saadr95/AquaControl/3d/v1.0/AquaControl_Divider.stl

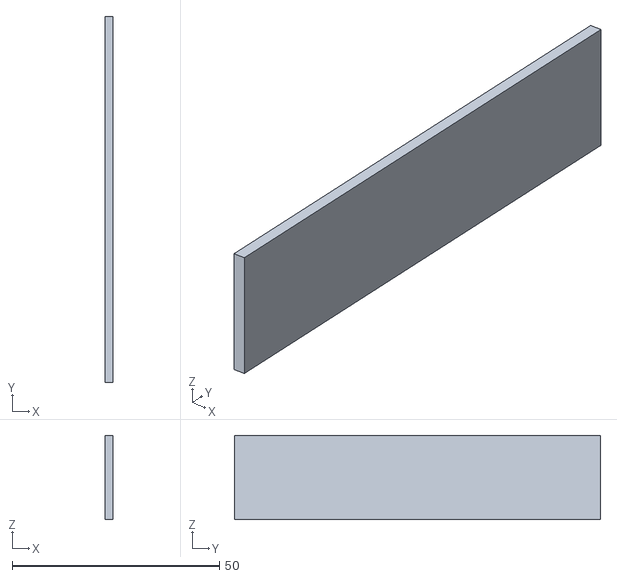
[picture p1: CAD file, 2026-08-20]
3d/v1.0/AquaControl_Divider.stl
2.00 x 88.4 x 20.4
