saadr95/AquaControl/3d/v1.0/AquaControl_Base.stl

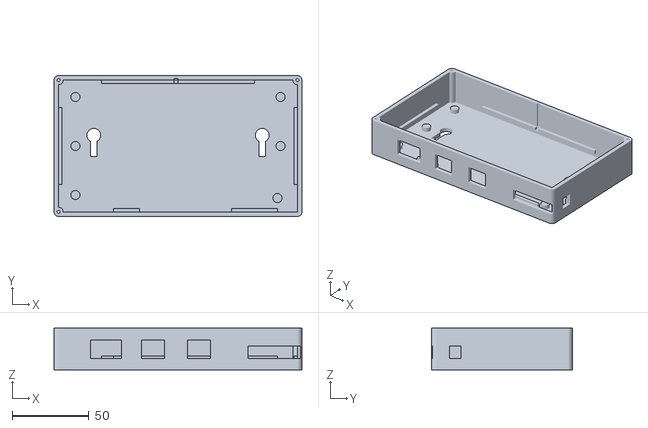
[picture p2: CAD file, 2026-08-20]
3d/v1.0/AquaControl_Base.stl
162.0 x 92.0 x 27.4
