saadr95/AquaControl/3d/v1.0/AquaControl_Enclosure.stl

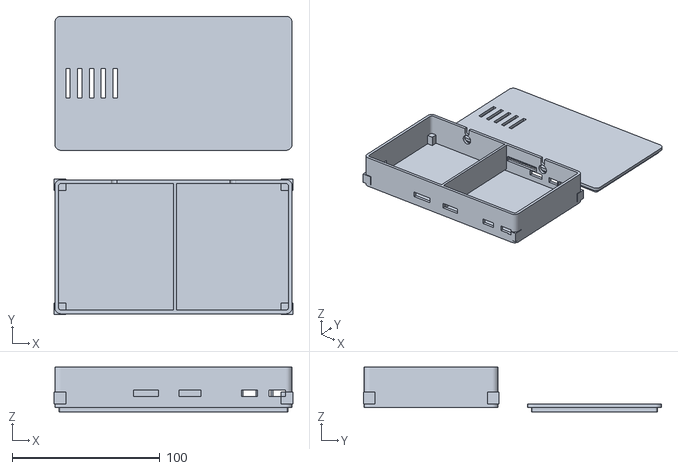
[picture p3: CAD file, 2026-08-20]
3d/v1.0/AquaControl_Enclosure.stl
162.0 x 202.2 x 30.4
