saadr95/AquaControl/3d/v1.0/AquaControl_Lid.stl

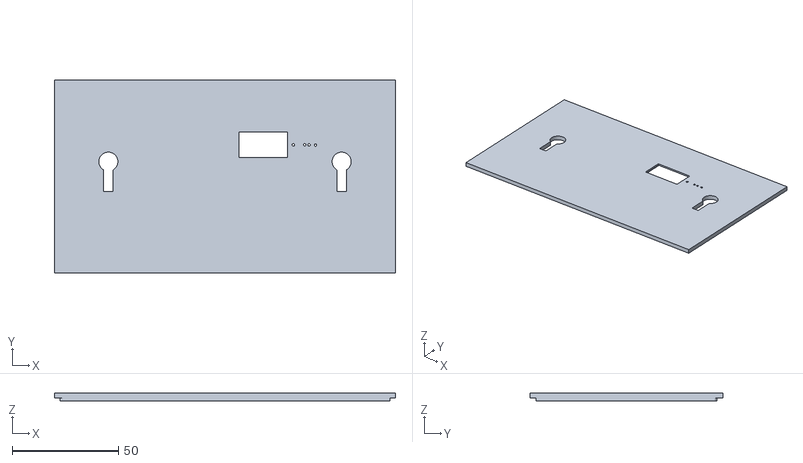
[picture p4: CAD file, 2026-08-20]
3d/v1.0/AquaControl_Lid.stl
160.8 x 90.8 x 3.90
