saadr95/AquaControl/kicad/v1.0/Esp32-01.pdf

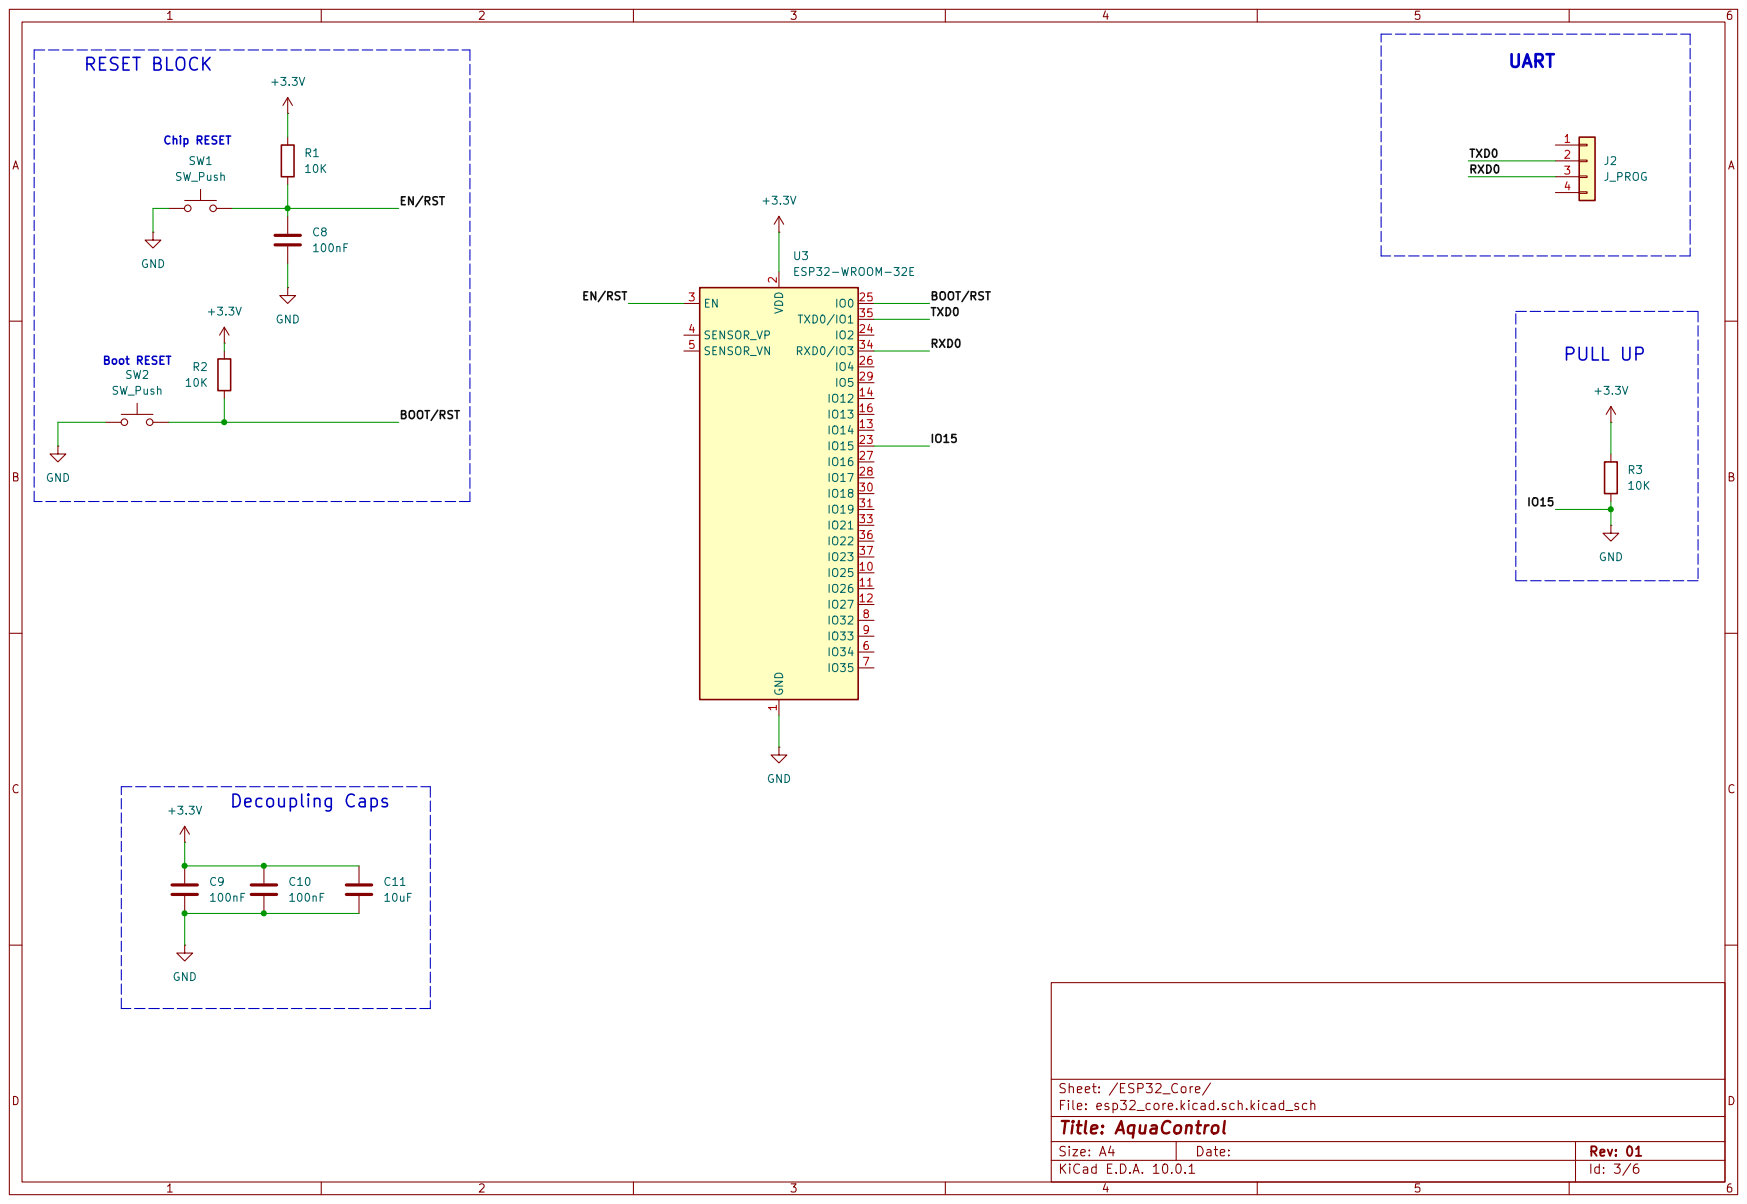
[picture p5: page 1]
