saadr95/AquaControl/(list of files, drawings)

Other design files:
kicad/v1.1/freerouting.dsn
kicad/v1.1/temp-freerouting.dsn
