saadr95/AquaControl/kicad/v1.1/AquaControl.kicad_pcb

## KiCad design kicad/v1.1/AquaControl.kicad_pcb (2026-08-20)

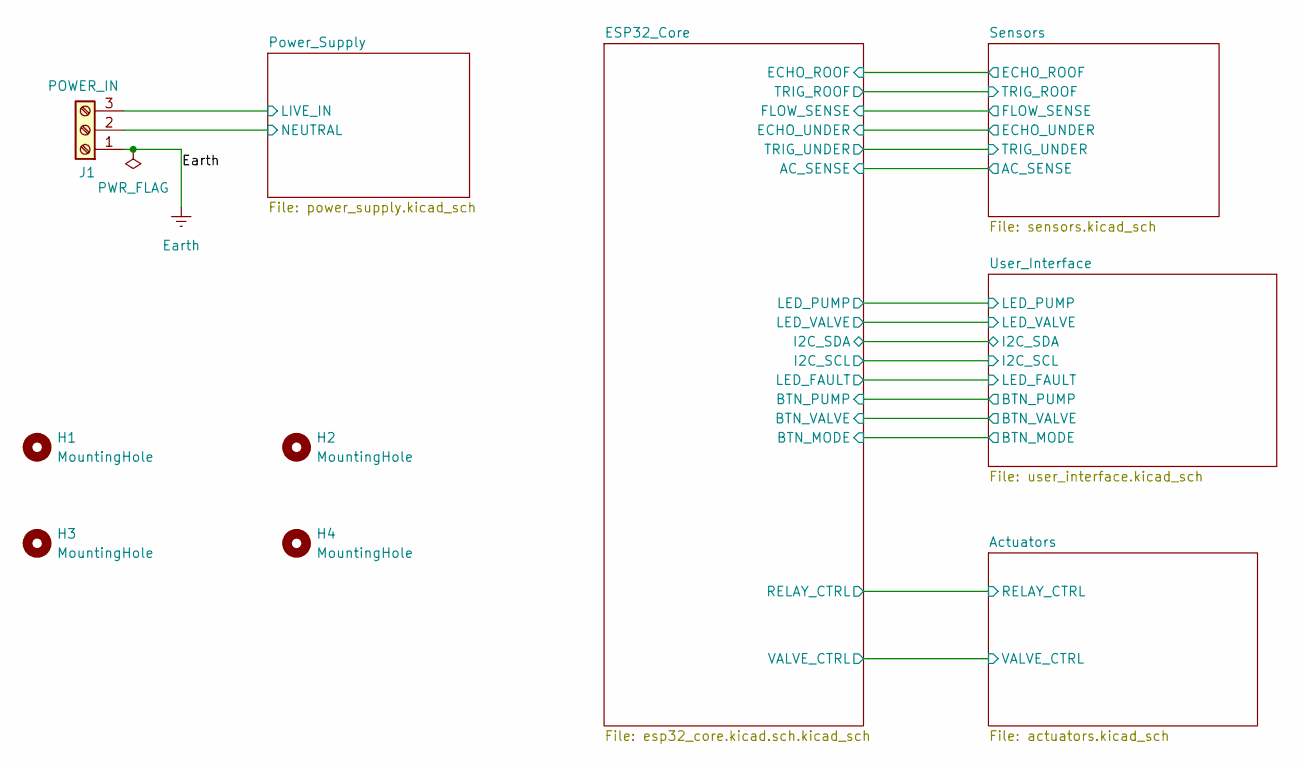
[picture p6: schematic AquaControl.kicad_sch]

Parts:
H1, H2, H3, H4: MountingHole; MountingHole_3.2mm_M3
J1: POWER_IN; TerminalBlock_Phoenix_MKDS-1,5-3_1x03_P5.00mm_Horizontal; LCSC C8427

Connections:
/Power_Supply/LIVE_IN: J1.3; also elsewhere on the board
/Power_Supply/NEUTRAL: J1.2; also elsewhere on the board
Earth: J1.1

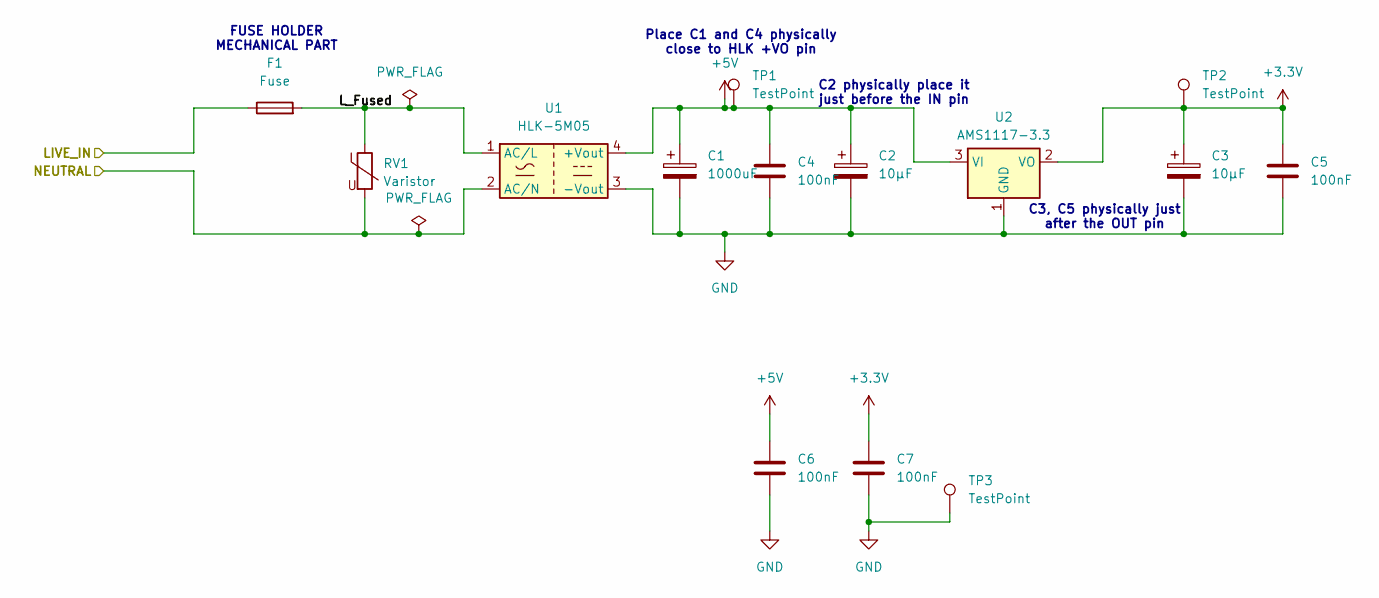
[picture p7: schematic power_supply.kicad_sch, AquaControl]

Parts:
C1: 1000uF; CP_Radial_D10.0mm_P5.00mm; LCSC C503217
C2, C3: 10µF; CP_Radial_D5.0mm_P2.50mm; LCSC C19712075
C4, C5, C6, C7: 100nF; C_0603_1608Metric; LCSC C14663
F1: Fuse; Fuseholder_Cylinder-5x20mm_Bulgin_FX0456_Vertical_Closed
RV1: Varistor; RV_Disc_D9mm_W3.3mm_P5mm; LCSC C125492
TP1, TP2, TP3: TestPoint; TestPoint_Pad_D1.0mm
U1: HLK-5M05; Converter_ACDC_Hi-Link_HLK-5Mxx; LCSC C48935095
U2: AMS1117-3.3; SOT-223-3_TabPin2; LCSC C6186

Connections:
+3.3V: C3.1, C5.1, C7.1, TP2.1 (1_1), U2.2 (VO); also elsewhere on the board
+5V: C1.1, C2.1, C4.1, C6.1, TP1.1 (1_1), U1.4 (+Vout), U2.3 (VI); also elsewhere on the board
/Power_Supply/LIVE_IN: F1.1; also elsewhere on the board
/Power_Supply/L_Fused: F1.2, RV1.1, U1.1 (AC/L)
/Power_Supply/NEUTRAL: RV1.2, U1.2 (AC/N); also elsewhere on the board
GND: C1.2, C2.2, C3.2, C4.2, C5.2, C6.2, C7.2, TP3.1 (1_1), U1.3 (-Vout), U2.1 (GND); also elsewhere on the board

Notes on the sheet:
C2 physically place it just before the IN pin
Place C1 and C4 physically close to HLK +VO pin
FUSE HOLDER MECHANICAL PART
C3, C5 physically just after the OUT pin

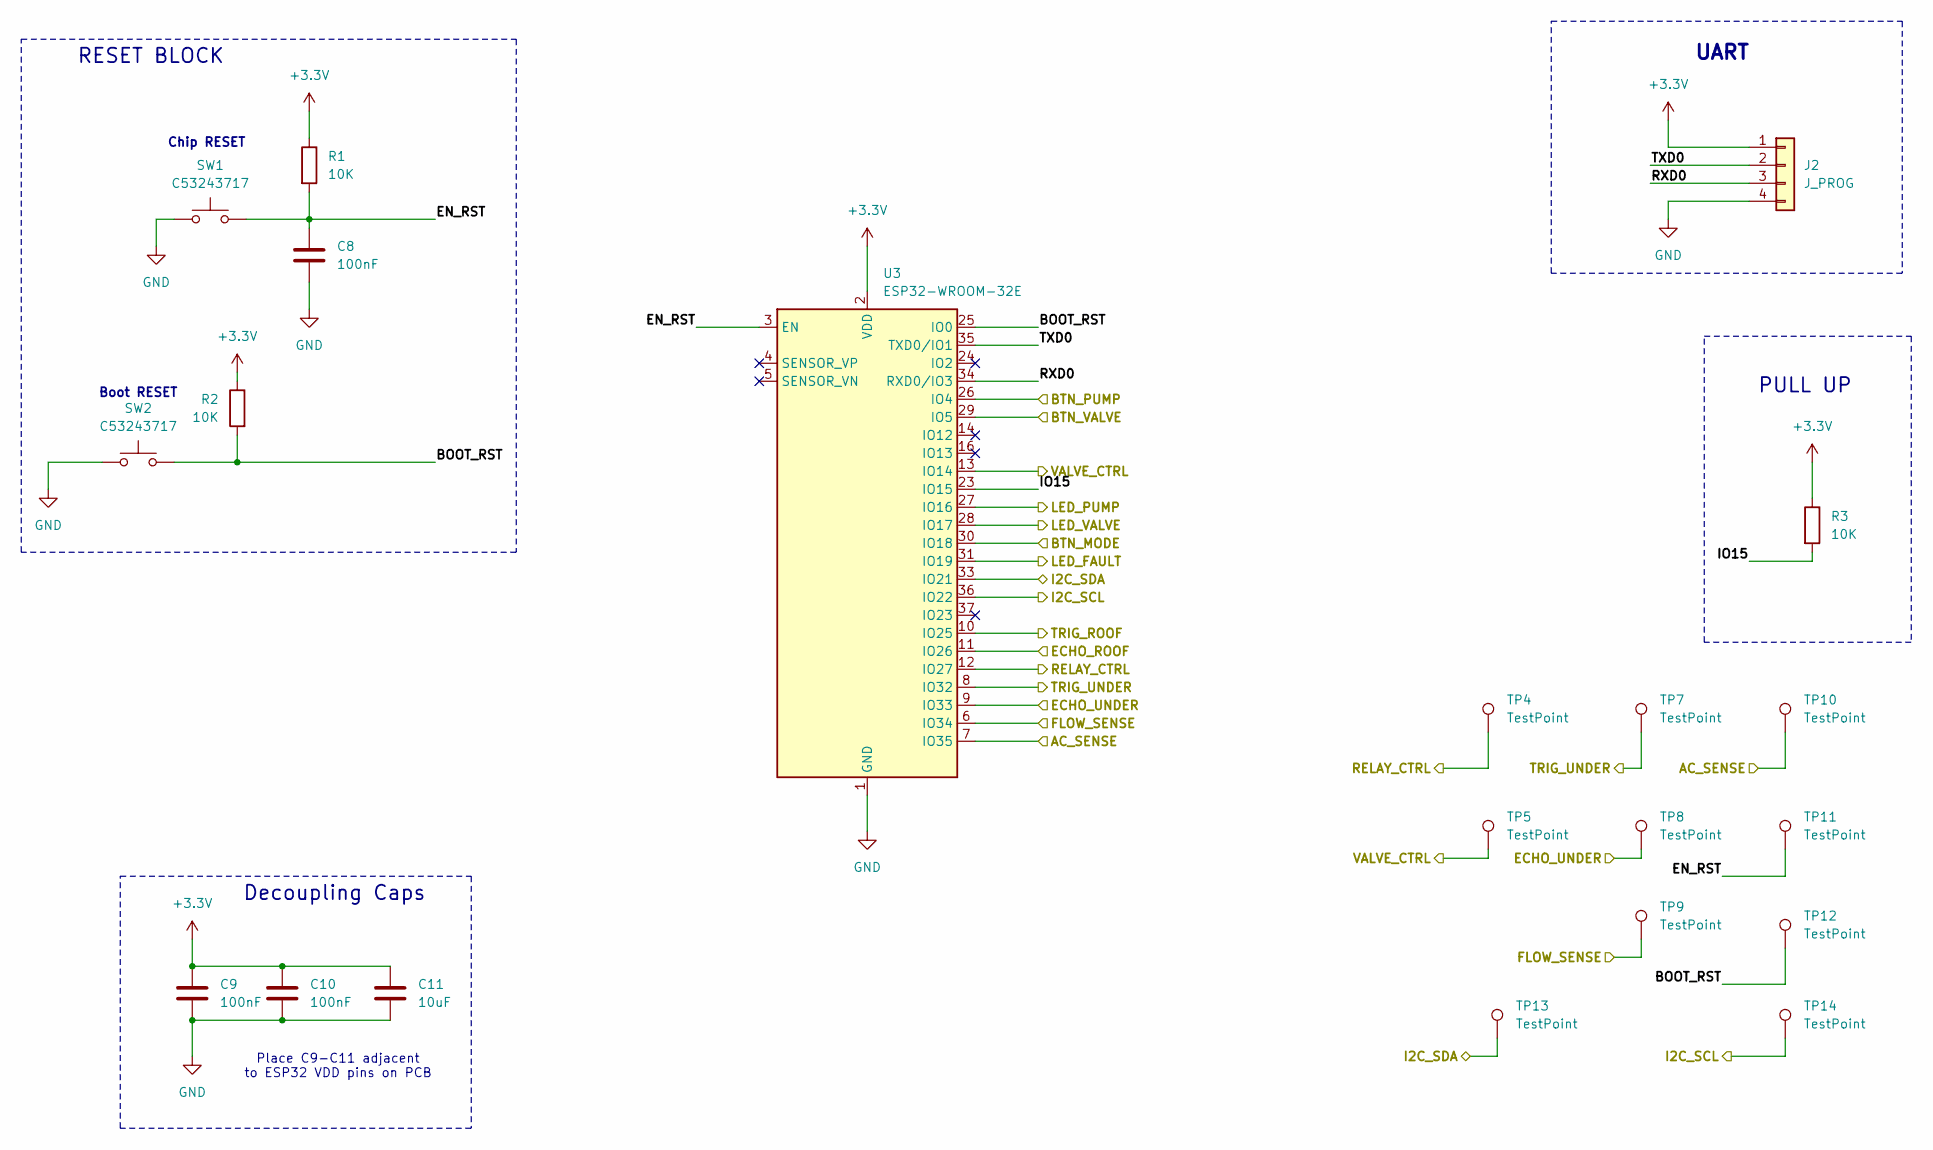
[picture p8: schematic esp32_core.kicad.sch.kicad_sch, AquaControl]

Parts:
C8, C9, C10: 100nF; C_0603_1608Metric; LCSC C14663
C11: 10uF; C_0603_1608Metric; LCSC C6119842
J2: J_PROG; PinHeader_1x04_P2.54mm_Vertical; LCSC C5116483
R1, R2, R3: 10K; R_0603_1608Metric; LCSC C2906982
SW1, SW2: C53243717; SW_PUSH_6mm_H4.3mm
TP4, TP5, TP7, TP8, TP9, TP10, TP11, TP12, TP13, TP14: TestPoint; TestPoint_Pad_D1.0mm
U3: ESP32-WROOM-32E; ESP32-WROOM-32D; LCSC C701341

Connections:
+3.3V: C9.1, C10.1, C11.1, J2.1, R1.1, R2.1, R3.1, U3.2 (VDD); also elsewhere on the board
/Actuators/RELAY_CTRL: TP4.1 (1_1), U3.12 (IO27); also elsewhere on the board
/Actuators/VALVE_CTRL: TP5.1 (1_1), U3.13 (IO14); also elsewhere on the board
/ESP32_Core/AC_SENSE: TP10.1 (1_1), U3.7 (IO35); also elsewhere on the board
/ESP32_Core/BOOT_RST: R2.2, SW2.1, TP12.1 (1_1), U3.25 (IO0)
/ESP32_Core/BTN_MODE: U3.30 (IO18); also elsewhere on the board
/ESP32_Core/BTN_PUMP: U3.26 (IO4); also elsewhere on the board
/ESP32_Core/BTN_VALVE: U3.29 (IO5); also elsewhere on the board
/ESP32_Core/ECHO_ROOF: U3.11 (IO26); also elsewhere on the board
/ESP32_Core/ECHO_UNDER: TP8.1 (1_1), U3.9 (IO33); also elsewhere on the board
/ESP32_Core/EN_RST: C8.1, R1.2, SW1.2, TP11.1 (1_1), U3.3 (EN)
/ESP32_Core/FLOW_SENSE: TP9.1 (1_1), U3.6 (IO34); also elsewhere on the board
/ESP32_Core/I2C_SCL: TP14.1 (1_1), U3.36 (IO22); also elsewhere on the board
/ESP32_Core/I2C_SDA: TP13.1 (1_1), U3.33 (IO21); also elsewhere on the board
/ESP32_Core/IO15: R3.2, U3.23 (IO15)
/ESP32_Core/LED_FAULT: U3.31 (IO19); also elsewhere on the board
/ESP32_Core/LED_PUMP: U3.27 (IO16); also elsewhere on the board
/ESP32_Core/LED_VALVE: U3.28 (IO17); also elsewhere on the board
/ESP32_Core/RXD0: J2.3, U3.34 (RXD0/IO3)
/ESP32_Core/TRIG_ROOF: U3.10 (IO25); also elsewhere on the board
/ESP32_Core/TRIG_UNDER: TP7.1 (1_1), U3.8 (IO32); also elsewhere on the board
/ESP32_Core/TXD0: J2.2, U3.35 (TXD0/IO1)
GND: C8.2, C9.2, C10.2, C11.2, J2.4, SW1.1, SW2.2, U3.1 (GND), U3.15 (GND), U3.38 (GND), U3.39 (GND); also elsewhere on the board

Notes on the sheet:
UART
PULL UP
Decoupling Caps
RESET BLOCK
Boot RESET
Place C9-C11 adjacent to ESP32 VDD pins on PCB
Chip RESET

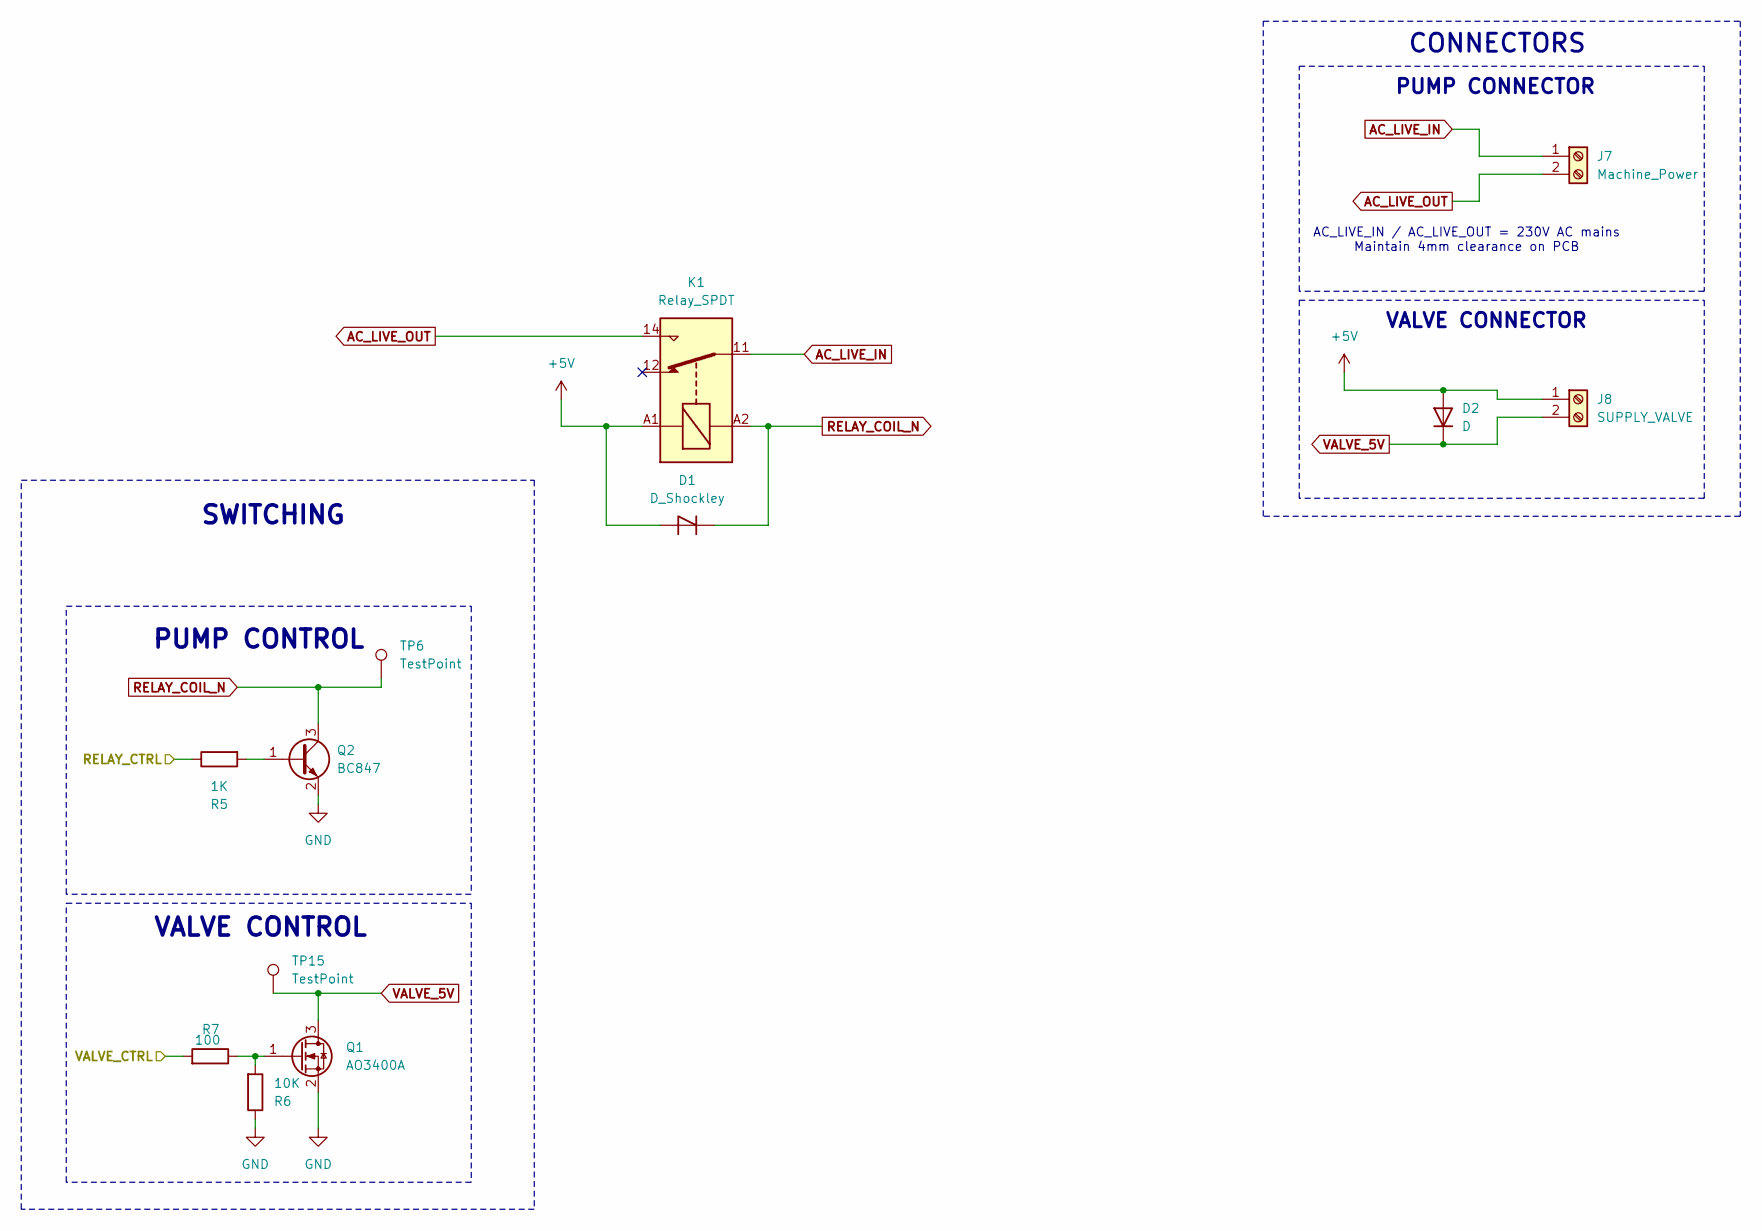
[picture p9: schematic actuators.kicad_sch, AquaControl]

Parts:
D1: D_Shockley; D_SMA; LCSC C2480
D2: D; D_SMA; LCSC C2480
J7: Machine_Power; TerminalBlock_Phoenix_MKDS-1,5-2_1x02_P5.00mm_Horizontal; LCSC C8439
J8: SUPPLY_VALVE; TerminalBlock_Phoenix_MKDS-1,5-2_1x02_P5.00mm_Horizontal; LCSC C8439
K1: Relay_SPDT; Relay_SPDT_Omron_G2RL-1; LCSC C1524672
Q1: AO3400A; SOT-23; LCSC C20917
Q2: BC847; SOT-23; LCSC C24698138
R5: 1K; R_0603_1608Metric; LCSC C2907002
R6: 10K; R_0603_1608Metric; LCSC C2906982
R7: 100; R_0603_1608Metric; LCSC C2906981
TP6, TP15: TestPoint; TestPoint_Pad_D1.0mm

Connections:
+5V: D1.2 (A), D2.2 (A), J8.1, K1.A1; also elsewhere on the board
/Actuators/RELAY_CTRL: R5.1; also elsewhere on the board
/Actuators/VALVE_CTRL: R7.2; also elsewhere on the board
AC_LIVE_IN: J7.1, K1.11
AC_LIVE_OUT: J7.2, K1.14
GND: Q1.2 (S), Q2.2 (E), R6.1; also elsewhere on the board
unnamed: Q1.1 (G), R6.2, R7.1
unnamed: Q2.1 (B), R5.2
RELAY_COIL_N: D1.1 (K), K1.A2, Q2.3 (C), TP6.1 (1_1)
VALVE_5V: D2.1 (K), J8.2, Q1.3 (D), TP15.1 (1_1)

Notes on the sheet:
VALVE CONTROL
VALVE CONNECTOR
CONNECTORS
PUMP CONTROL
SWITCHING
PUMP CONNECTOR
AC_LIVE_IN / AC_LIVE_OUT = 230V AC mains Maintain 4mm clearance on PCB

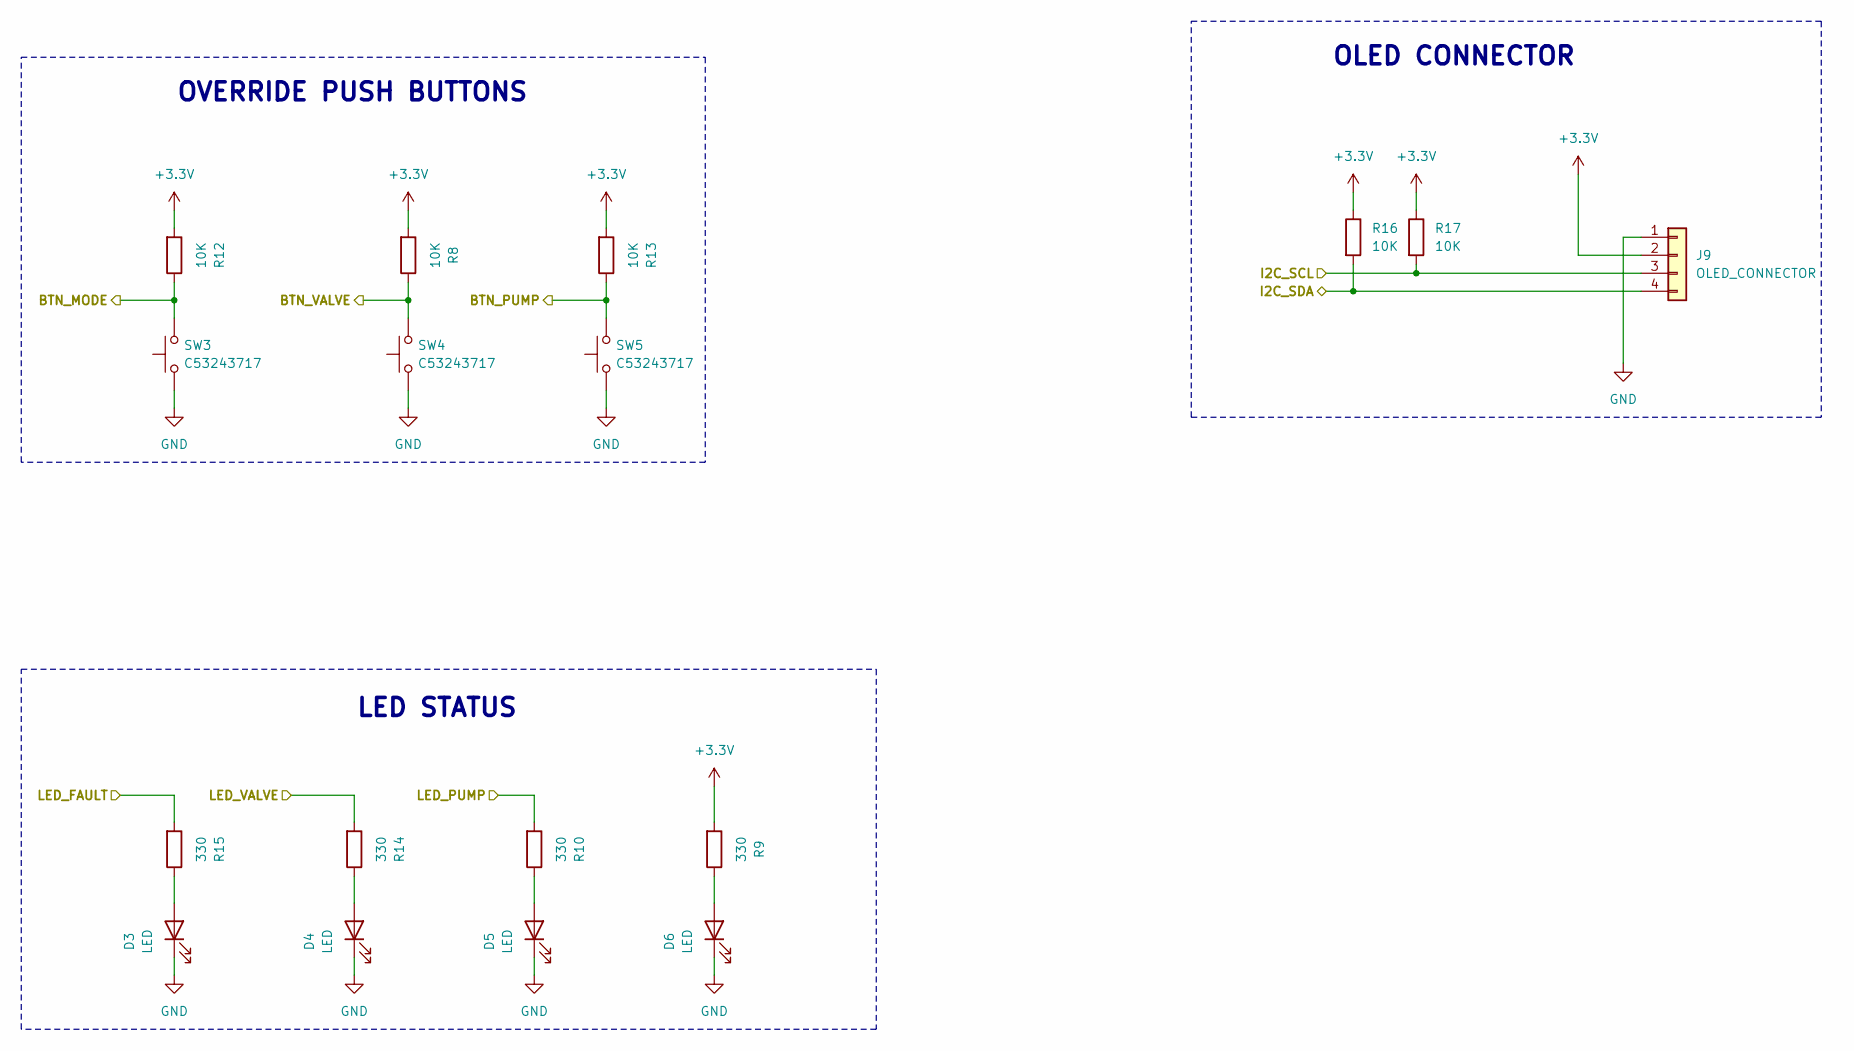
[picture p10: schematic user_interface.kicad_sch, AquaControl]

Parts:
D3, D4, D5, D6: LED; LED_0805_2012Metric; LCSC C84256
J9: OLED_CONNECTOR; Molex_PicoBlade_53047-0410_1x04_P1.25mm_Vertical; LCSC C5116483
R8, R12, R13, R16, R17: 10K; R_0603_1608Metric; LCSC C2906982
R9, R10, R14, R15: 330; R_0603_1608Metric; LCSC C701341
SW3, SW4, SW5: C53243717; SW_PUSH_6mm_H4.3mm

Connections:
+3.3V: J9.2, R8.2, R9.2, R12.2, R13.2, R16.1, R17.1; also elsewhere on the board
/ESP32_Core/BTN_MODE: R12.1, SW3.2; also elsewhere on the board
/ESP32_Core/BTN_PUMP: R13.1, SW5.2; also elsewhere on the board
/ESP32_Core/BTN_VALVE: R8.1, SW4.2; also elsewhere on the board
/ESP32_Core/I2C_SCL: J9.3, R17.2; also elsewhere on the board
/ESP32_Core/I2C_SDA: J9.4, R16.2; also elsewhere on the board
/ESP32_Core/LED_FAULT: R15.2; also elsewhere on the board
/ESP32_Core/LED_PUMP: R10.2; also elsewhere on the board
/ESP32_Core/LED_VALVE: R14.2; also elsewhere on the board
GND: D3.1 (K), D4.1 (K), D5.1 (K), D6.1 (K), J9.1, SW3.1, SW4.1, SW5.1; also elsewhere on the board
unnamed: D3.2 (A), R15.1
unnamed: D4.2 (A), R14.1
unnamed: D5.2 (A), R10.1
unnamed: D6.2 (A), R9.1

Notes on the sheet:
OLED CONNECTOR
OVERRIDE PUSH BUTTONS
LED STATUS

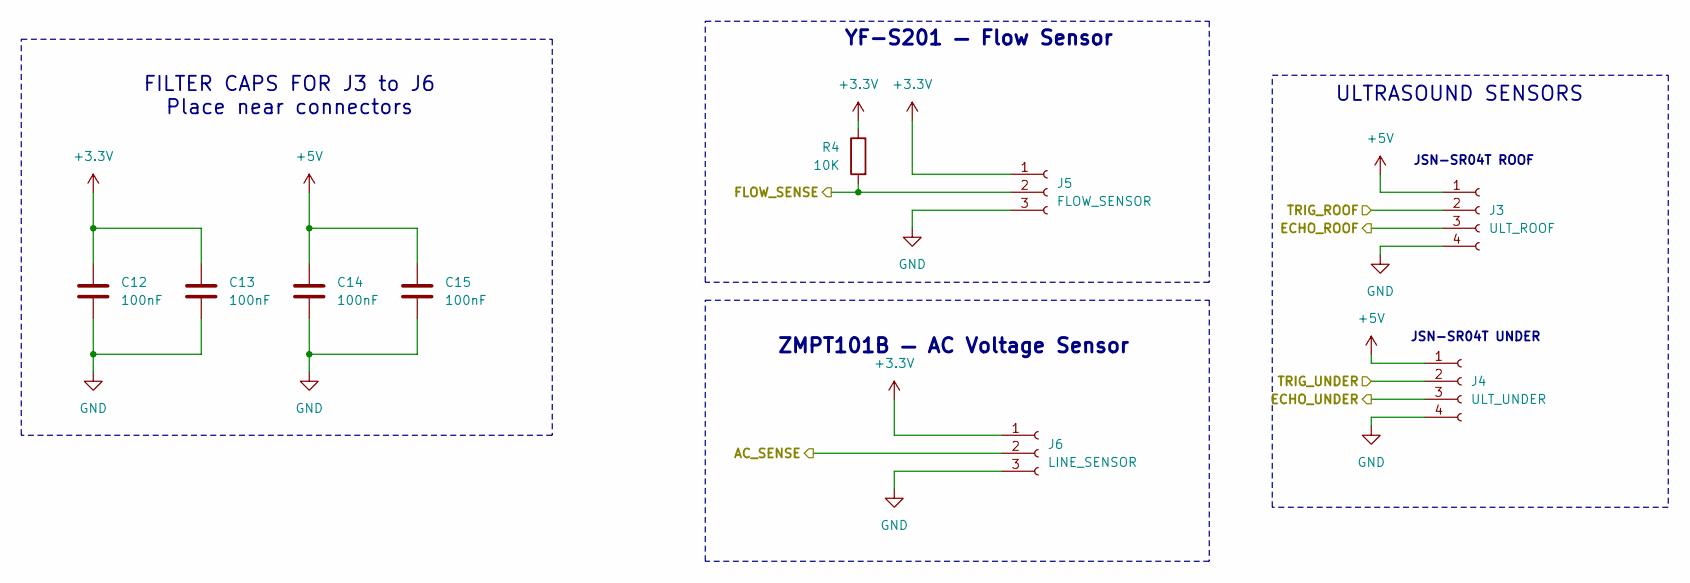
[picture p11: schematic sensors.kicad_sch, AquaControl]

Parts:
C12, C13, C14, C15: 100nF; C_0603_1608Metric; LCSC C14663
J3: ULT_ROOF; Molex_KK-254_AE-6410-04A_1x04_P2.54mm_Vertical; LCSC C5116483
J4: ULT_UNDER; Molex_KK-254_AE-6410-04A_1x04_P2.54mm_Vertical; LCSC C5116483
J5: FLOW_SENSOR; Molex_KK-254_AE-6410-03A_1x03_P2.54mm_Vertical; LCSC C429954
J6: LINE_SENSOR; Molex_KK-254_AE-6410-03A_1x03_P2.54mm_Vertical; LCSC C429954
R4: 10K; R_0603_1608Metric; LCSC C2906982

Connections:
+3.3V: C12.1, C13.1, J5.1, J6.1, R4.1; also elsewhere on the board
+5V: C14.1, C15.1, J3.1, J4.1; also elsewhere on the board
/ESP32_Core/AC_SENSE: J6.2; also elsewhere on the board
/ESP32_Core/ECHO_ROOF: J3.3; also elsewhere on the board
/ESP32_Core/ECHO_UNDER: J4.3; also elsewhere on the board
/ESP32_Core/FLOW_SENSE: J5.2, R4.2; also elsewhere on the board
/ESP32_Core/TRIG_ROOF: J3.2; also elsewhere on the board
/ESP32_Core/TRIG_UNDER: J4.2; also elsewhere on the board
GND: C12.2, C13.2, C14.2, C15.2, J3.4, J4.4, J5.3, J6.3; also elsewhere on the board

Notes on the sheet:
JSN-SR04T ROOF
FILTER CAPS FOR J3 to J6 Place near connectors
ZMPT101B — AC Voltage Sensor
ULTRASOUND SENSORS
JSN-SR04T UNDER
YF-S201 — Flow Sensor

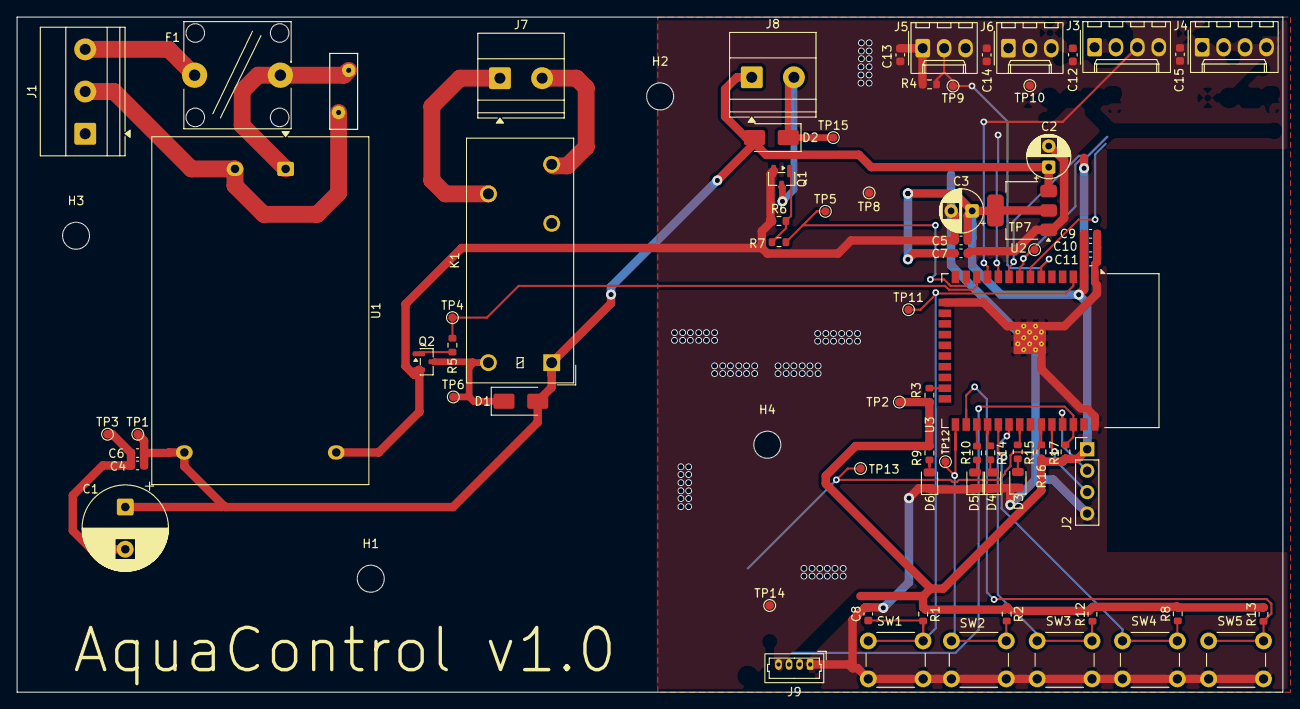
[picture p12: board AquaControl.kicad_pcb from above]

Board: 2 copper layers, 150.0 x 80.0 mm, 78 parts (0 on the bottom side), 37 nets.
