saadr95/AquaControl/(commit log)

2026-08-10 Initial commit: AquaControl IoT water management system
    ESP32 firmware (MQTT, multi-device identity, WiFi captive-portal
    provisioning, flow rate tracking), React web dashboard, React Native
    Android app, and MQTT-to-FCM push relay. KiCad hardware design included.
    [AquaControl.csv, AquaControl.kicad_pcb, AquaControl.kicad_sch, actuators.kicad_sch, esp32_core.kicad.sch.kicad_sch, power_supply.kicad_sch, sensors.kicad_sch, user_interface.kicad_sch]
2026-08-10 Add remote OTA updates and fix grid-sensing false triggers
    Firmware: OTA_UPDATE MQTT command downloads and flashes the latest
    GitHub release (HTTPUpdate over HTTPS), refusing to start while the
    pump/valve is active since the download blocks the safety-check loop.
    Switched to the min_spiffs partition scheme for OTA headroom (63% flash
    usage vs 95% on the default scheme). Debounced grid-power sensing so a
    single noisy AC_SENSE reading can't cascade into a false grid-loss event,
    and exposed the raw variation reading for threshold calibration.
    Both apps: Update Firmware button (with confirmation, disabled while
    pump/valve active) and live AC-sense variation readout under Grid Power.
    [config.h, mqtt_handler.h, ota.h, sensors.h, state_machine.h]
2026-08-11 Fix OTA download failing on GitHub's redirect chain
    httpUpdate.update() was seeing GitHub's 302 (github.com -> a signed
    blob-storage URL) instead of following it, failing with "Wrong HTTP
    Code". Confirmed via a live OTA test on real hardware: the fix works —
    a v1.1.2 board successfully downloaded and flashed itself over the air.
    [config.h, ota.h]
2026-08-11 Show OTA progress on the OLED
    Progress bar during download (hooked into httpUpdate's onProgress
    callback), a failure screen if it doesn't work out, and the running
    firmware version on the boot screen so a successful OTA reboot is
    visible at a glance without needing the app.
    [config.h, display.h, ota.h]
2026-08-11 Bump to v1.1.4 (test release — proves OTA works without a USB cable)
2026-08-11 Fix device ID collision between boards from the same batch
    deviceShortId was derived from the lower 24 bits of the MAC address,
    which is exactly where the OUI (manufacturer prefix) lives — boards
    from the same production batch share it, so two physically different
    units ended up with the same ID, topic path, and MQTT client ID
    simultaneously. Found live: the web dashboard's device picker showed
    both boards under one identical ID. Now uses the full 48-bit MAC.
    [config.h, identity.h]
2026-08-12 Add remote board renaming (SET_NAME command)
    The WiFi portal's naming step never actually triggers when a board
    already has cached WiFi credentials (as both bench boards did from
    earlier testing), leaving them stuck on the default "Board-<id>" name.
    This adds a rename button in both apps that publishes {"cmd":"SET_NAME",
    "name":"..."} directly, no portal or physical access needed.
    [config.h, mqtt_handler.h, state_machine.h]
2026-08-20 Reorganize into versioned coding/app/kicad/3d structure; add multi-tenant Firebase auth
    - Split the repo into coding/, app/, kicad/, 3d/, each with vX.Y subfolders,
    so firmware and hardware revisions can be tracked independently.
    - Firmware: authenticated TLS MQTT to a private HiveMQ Cloud broker.
    - New mqtt-fcm-relay bridge service: mirrors MQTT status/alerts into
    Firestore, relays pending_commands back to MQTT, sends per-device FCM push.
    - Firestore security rules: customer accounts see/control only their own
    claimed devices; admin accounts see and control the whole fleet; OTA
    firmware updates are admin-only, enforced server-side.
    - Web dashboard and Android app: Firebase Auth logi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
    [AquaControl.csv, AquaControl.kicad_pcb, AquaControl.kicad_sch, AquaControl_Base.stl, AquaControl_Divider.stl, AquaControl_Enclosure.stl, AquaControl_Lid.stl, actuators.kicad_sch]
